modi0903/smart-classroom-stm32/docs/reports/final-review-slides.pdf

# Smart Classroom

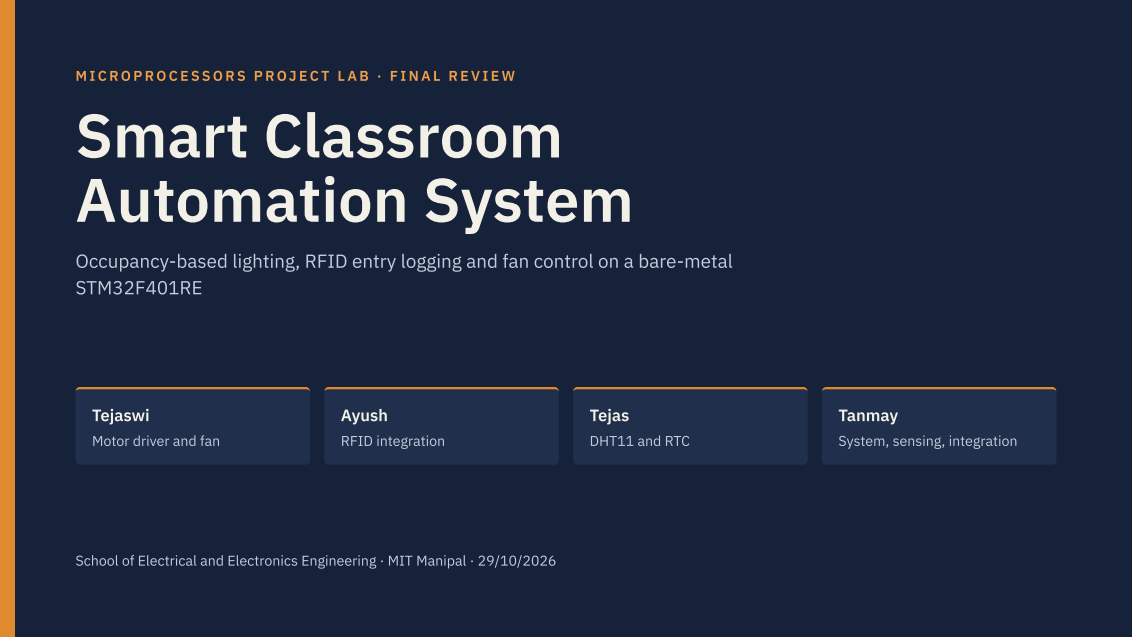
[picture p11: page 1]
Tejaswi; Ayush; RFID integration; Tejas; DHT11 and RTC; Tanmay

Automation System

Occupancy-based lighting, RFID entry logging and fan control on a bare-metal
STM32F401RE

Motor driver and fan

System, sensing, integration

School of Electrical and Electronics Engineering · MIT Manipal · 29/10/2026

AGENDA

# Presentation flow

# System overview, occupancy sensing and lighting

Problem, architecture, firmware structure, ultrasonic zones, debounce, lighting

RC522 on SPI2, ISO 14443-A card read, roster and lockout, link to the system

IRLZ44N low-side stage, TIM1 PWM at 20 kHz, button fan levels, RFID gating

DHT11 single-wire protocol, RTC clock source, backup domain, serial time setting

Interrupts, one-button screens, roster, class sessions, OLED, testing, demo

## Smart Classroom Automation System

INTRODUCTION

# Problem and objectives

# Classroom lights and fans are often

left running after the room empties.

Manual switching depends on the last person to leave,

and a fixed timer cannot tell whether anyone is present.

The loads should follow actual occupancy, ambient

light and the number of people inside.

# Objectives

1. Detect occupancy in two zones using ultrasonic ranging
2. Switch and dim zone lights by occupancy and ambient light
3. Record entry and exit at the door with RFID cards
4. Run the fan only while someone is inside, at a set speed
5. Display temperature, humidity, date and time
6. Write all firmware at register level, using interrupts

# System block diagram

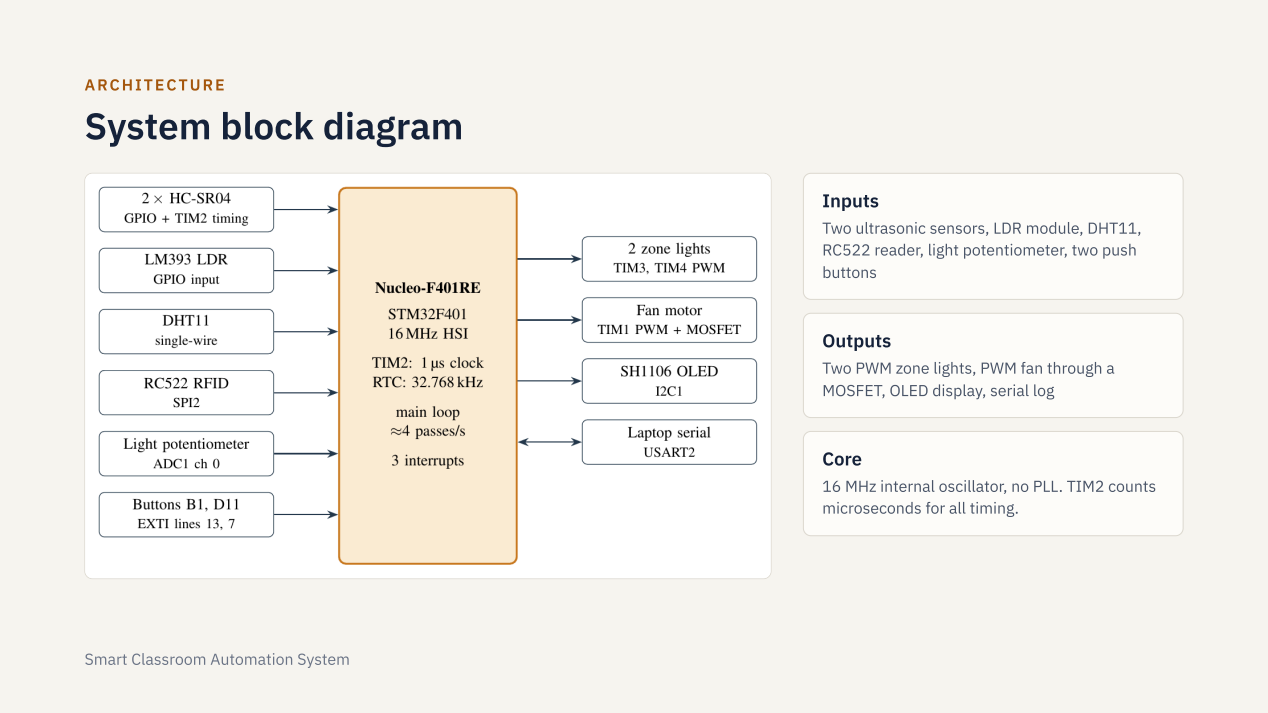
[picture p12: page 4]
ARCHITECTURE; Inputs; buttons; Outputs; Core

Two ultrasonic sensors, LDR module, DHT11,

RC522 reader, light potentiometer, two push

Two PWM zone lights, PWM fan through a

MOSFET, OLED display, serial log

16 MHz internal oscillator, no PLL. TIM2 counts

microseconds for all timing.

# How the platform was chosen

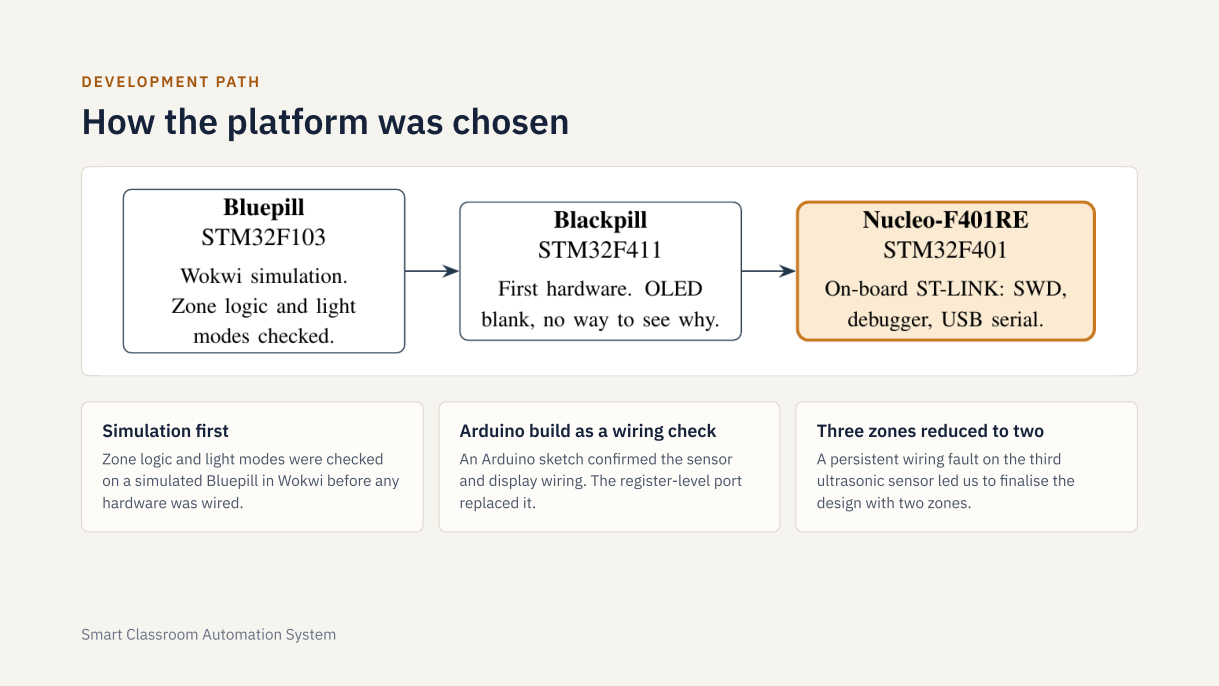
[picture p13: page 5]
DEVELOPMENT PATH; Simulation first; replaced it.

Arduino build as a wiring check

Three zones reduced to two

Zone logic and light modes were checked

An Arduino sketch confirmed the sensor

A persistent wiring fault on the third

on a simulated Bluepill in Wokwi before any

and display wiring. The register-level port

ultrasonic sensor led us to finalise the

hardware was wired.

design with two zones.

# Bare-metal structure and peripheral map

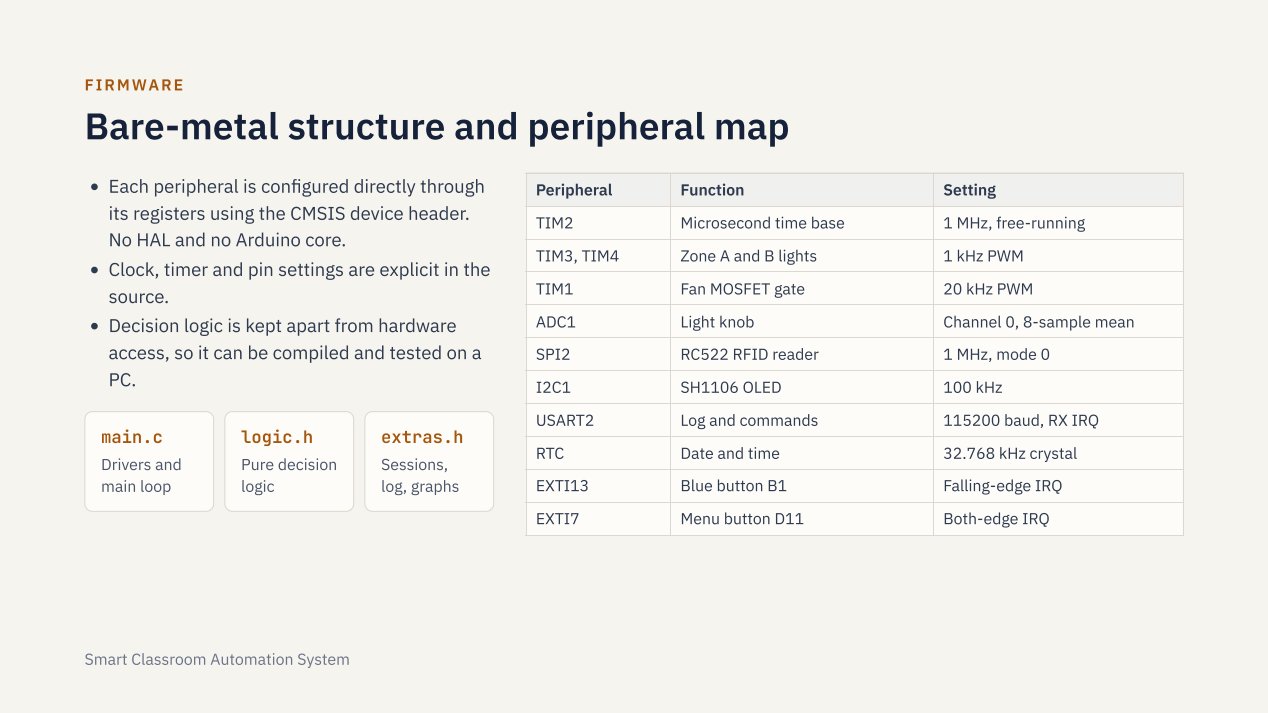
[picture p14: page 6]
FIRMWARE; source.; main.c; Drivers and; main loop; logic.h; Pure decision; logic; extras.h; Sessions,; log, graphs

Each peripheral is configured directly through

Peripheral | Function | Setting

its registers using the CMSIS device header.

TIM2 | Microsecond time base | 1 MHz, free-running

No HAL and no Arduino core.

TIM3, TIM4 | Zone A and B lights | 1 kHz PWM

Clock, timer and pin settings are explicit in the

TIM1 | Fan MOSFET gate | 20 kHz PWM

Decision logic is kept apart from hardware

ADC1 | Light knob | Channel 0, 8-sample mean

access, so it can be compiled and tested on a

SPI2 | RC522 RFID reader | 1 MHz, mode 0

I2C1 | SH1106 OLED | 100 kHz

USART2 | Log and commands | 115200 baud, RX IRQ

RTC | Date and time | 32.768 kHz crystal

EXTI13 | Blue button B1 | Falling-edge IRQ

EXTI7 | Menu button D11 | Both-edge IRQ

# One pass of the main loop, about 0.25 s

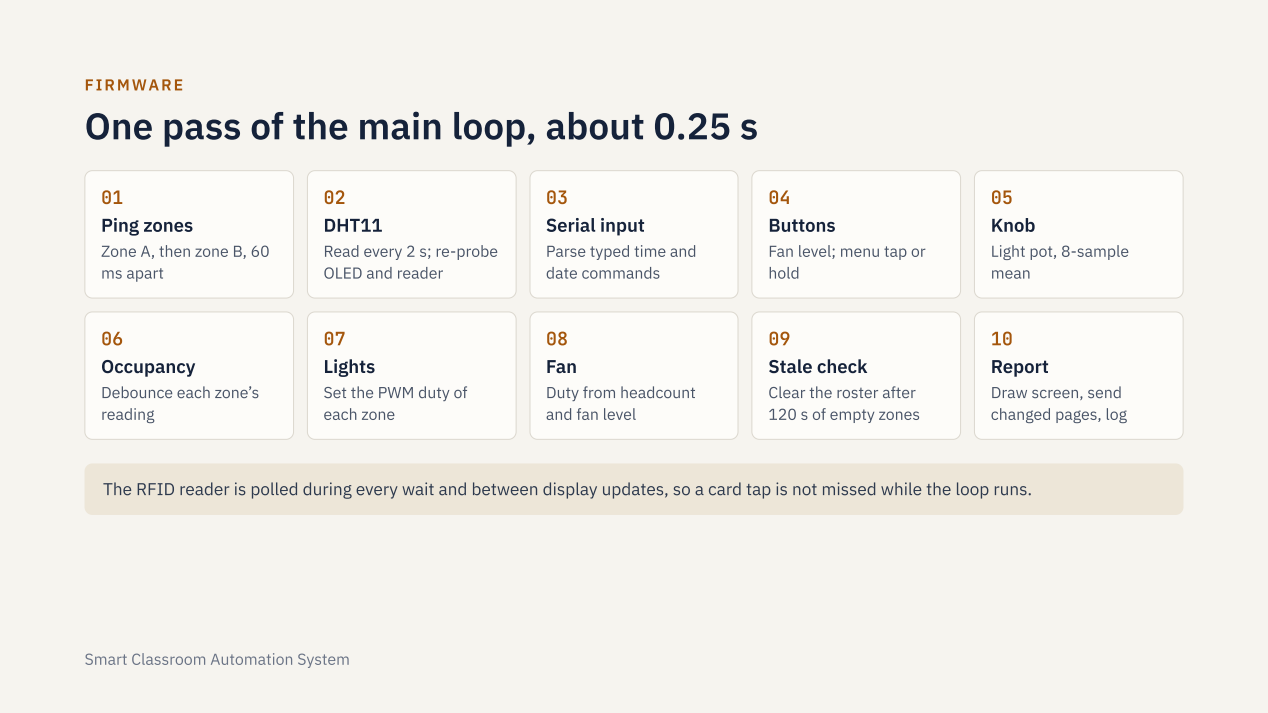
[picture p15: page 7]
FIRMWARE; Ping zones; ms apart; DHT11; Serial input; date commands; Buttons; Knob; mean; Occupancy; reading; Lights; each zone; Fan; Stale check; Report

Zone A, then zone B, 60

Read every 2 s; re-probe

Parse typed time and

Fan level; menu tap or
hold

Light pot, 8-sample

OLED and reader

Debounce each zone’s

Set the PWM duty of

Duty from headcount

Clear the roster after

Draw screen, send

and fan level

120 s of empty zones

changed pages, log

The RFID reader is polled during every wait and between display updates, so a card tap is not missed while the loop runs.

OCCUPANCY SENSING

# Ultrasonic distance measurement

# Measurement sequence

1. Drive TRIG high for 10 µs.
2. Wait up to 5 ms for ECHO to rise, else report NO ECHO.
3. Time the ECHO pulse on TIM2; beyond 25 ms, report FAR.
4. Distance in cm = echo time in µs ÷ 58.
5. A distance under 100 cm counts as a person present.

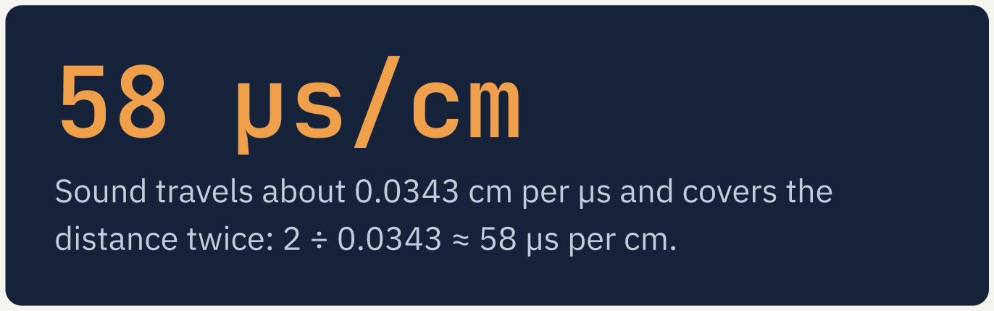
[picture p16: figure]

Sound travels about 0.0343 cm per µs and covers the

distance twice: 2 ÷ 0.0343 ≈ 58 µs per cm.

Zone | TRIG | ECHO
A | PA10 (D2) | PB3 (D3)
B | PB5 (D4) | PB4 (D5)

Sensors run from 5 V. The two zones are pinged 60 ms apart so one

sensor’s echo is not read by the other.

# Asymmetric debounce of each zone

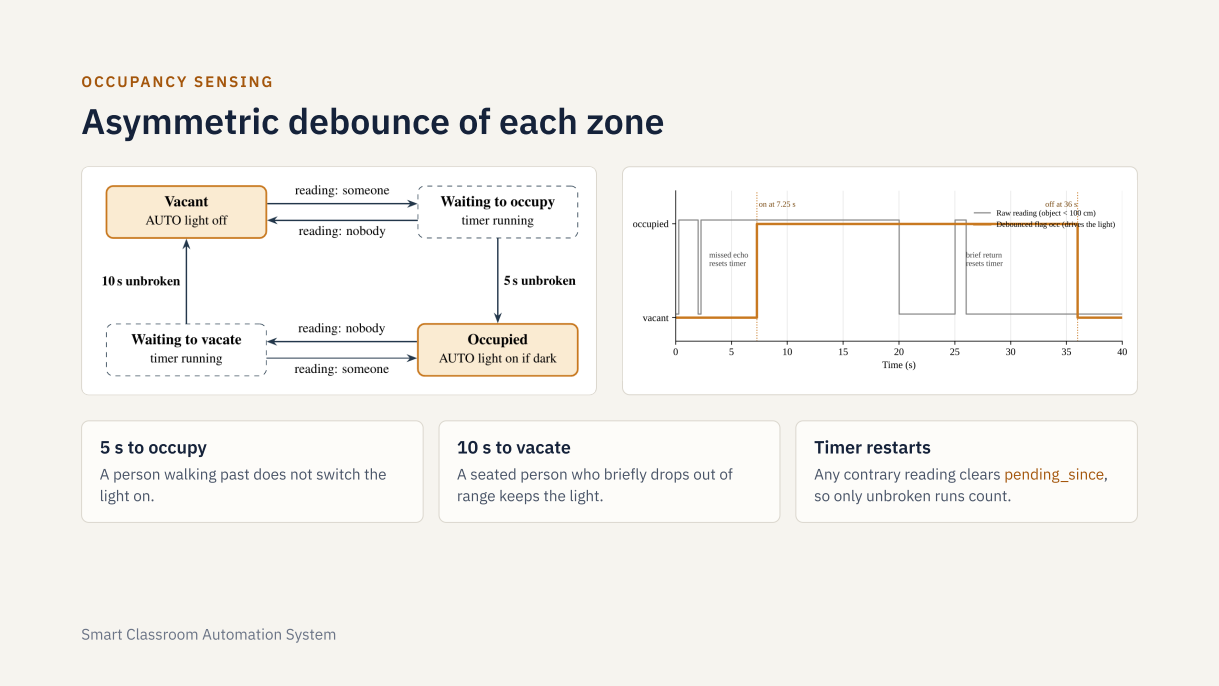
[picture p17: page 9]
OCCUPANCY SENSING; 5 s to occupy; 10 s to vacate

Timer restarts
Any contrary reading clears pending_since,

A person walking past does not switch the
light on.

A seated person who briefly drops out of

range keeps the light.

so only unbroken runs count.

LIGHTING

# Zone lights: modes, PWM and ambient light

Setting | Light output
OFF | Always off
AUTO (default) | Knob brightness when occupied and dark
DIM | Fixed low level, 10 % duty
MAX | Knob brightness at all times

Each zone’s mode is set at compile time; the final build runs both zones in AUTO.

There is no run-time override: the blue button now sets the fan level.

PWM outputs

TIM3 CH2 on PC7 (D9), TIM4 CH1 on PB6 (D10). 16 MHz ÷ 16 ÷

1000 = 1 kHz, duty 0 to 999.

Ambient light

LM393 module output on PB0, internal pull-up. HIGH means

dark.

Brightness knob

PA0 (A0), ADC1 channel 0. On the HOME screen the 12-bit

reading maps to duty 50 to 999, with a small dead band against

flicker.

02

# RFID entry at the door

## Reading ISO 14443-A cards with the RC522 over SPI, keeping a roster of who is

inside, and passing the headcount to the rest of the system.

# RC522 reader on SPI2

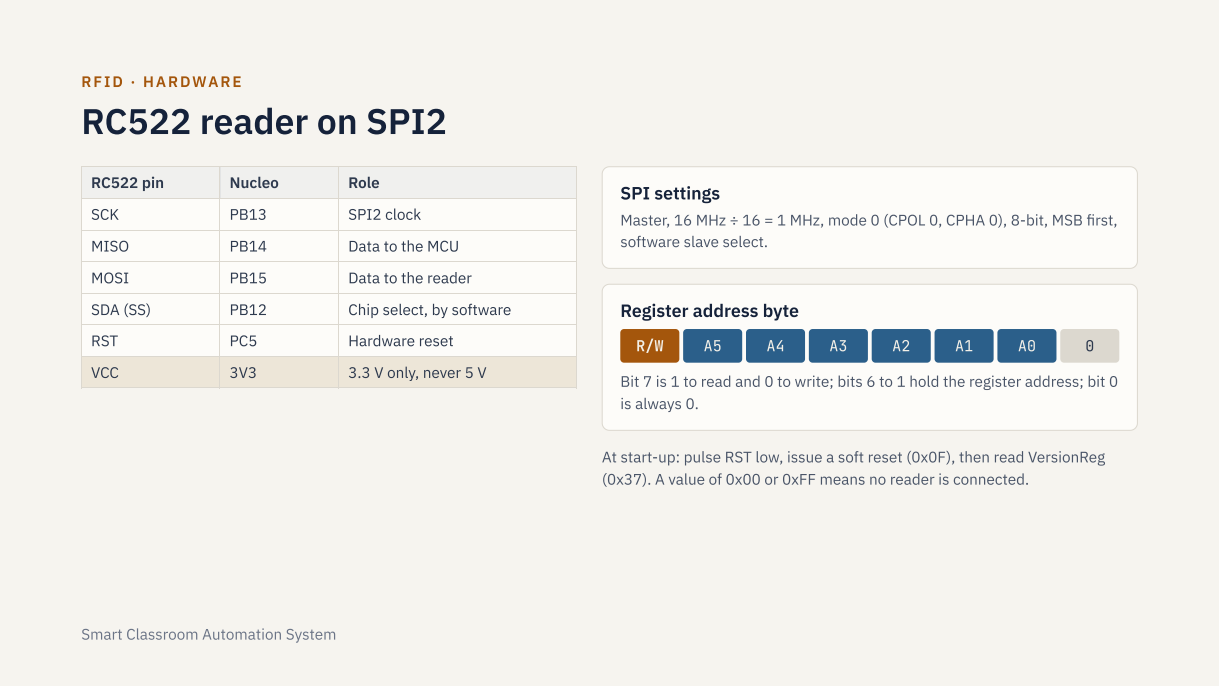
[picture p18: page 12]
RFID · HARDWARE; SPI settings; is always 0.

RC522 pin | Nucleo | Role

SCK | PB13 | SPI2 clock

Master, 16 MHz ÷ 16 = 1 MHz, mode 0 (CPOL 0, CPHA 0), 8-bit, MSB first,

MISO | PB14 | Data to the MCU

software slave select.

MOSI | PB15 | Data to the reader

SDA (SS) | PB12 | Chip select, by software

Register address byte

RST | PC5 | Hardware reset

VCC | 3V3 | 3.3 V only, never 5 V

Bit 7 is 1 to read and 0 to write; bits 6 to 1 hold the register address; bit 0

At start-up: pulse RST low, issue a soft reset (0x0F), then read VersionReg

(0x37). A value of 0x00 or 0xFF means no reader is connected.

# Reading a card, ISO 14443-A

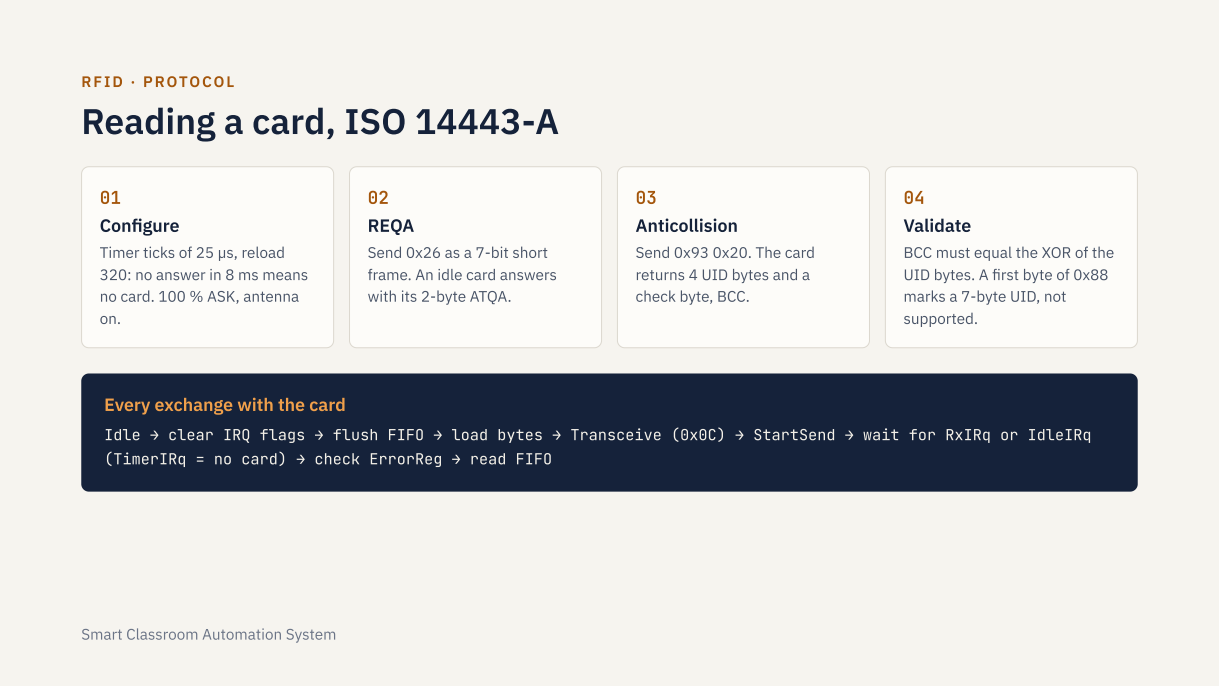
[picture p19: page 13]
RFID · PROTOCOL; Configure; REQA; Anticollision; Validate; supported.

Timer ticks of 25 µs, reload

Send 0x26 as a 7-bit short

Send 0x93 0x20. The card

BCC must equal the XOR of the

320: no answer in 8 ms means

frame. An idle card answers

returns 4 UID bytes and a

UID bytes. A first byte of 0x88

no card. 100 % ASK, antenna

with its 2-byte ATQA.

check byte, BCC.

marks a 7-byte UID, not

Every exchange with the card

Idle → clear IRQ flags → flush FIFO → load bytes → Transceive (0x0C) → StartSend → wait for RxIRq or IdleIRq

(TimerIRq = no card) → check ErrorReg → read FIFO

# Turning taps into a headcount

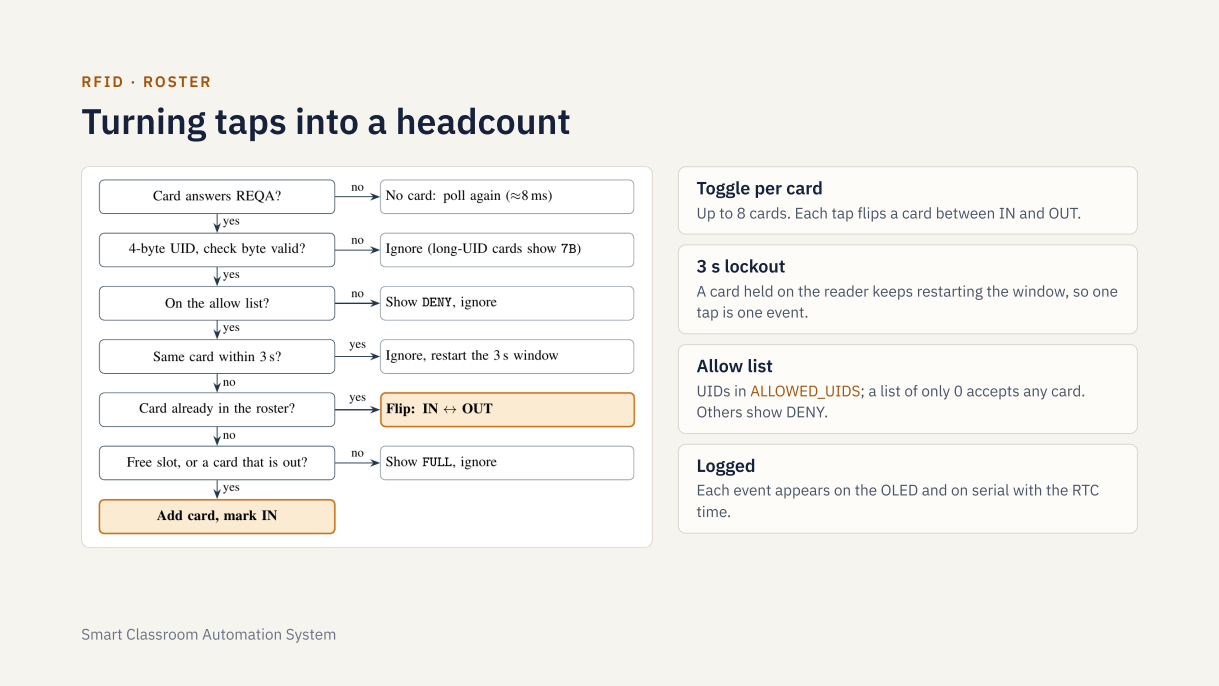
[picture p20: page 14]
RFID · ROSTER; 3 s lockout; Allow list; Logged; time.

Toggle per card

Up to 8 cards. Each tap flips a card between IN and OUT.

A card held on the reader keeps restarting the window, so one

tap is one event.

UIDs in ALLOWED_UIDS; a list of only 0 accepts any card.

Others show DENY.

Each event appears on the OLED and on serial with the RTC

RFID · INTEGRATION

# How the headcount drives the room

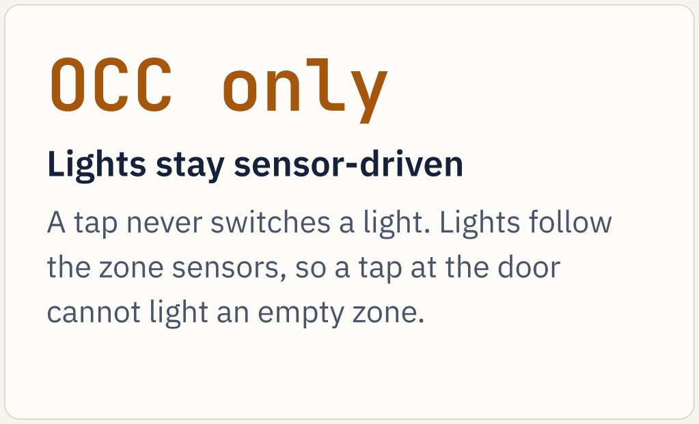
[picture p21: figure]
OCC only; Lights stay sensor-driven; the zone sensors, so a tap at the door; cannot light an empty zone.

A tap never switches a light. Lights follow

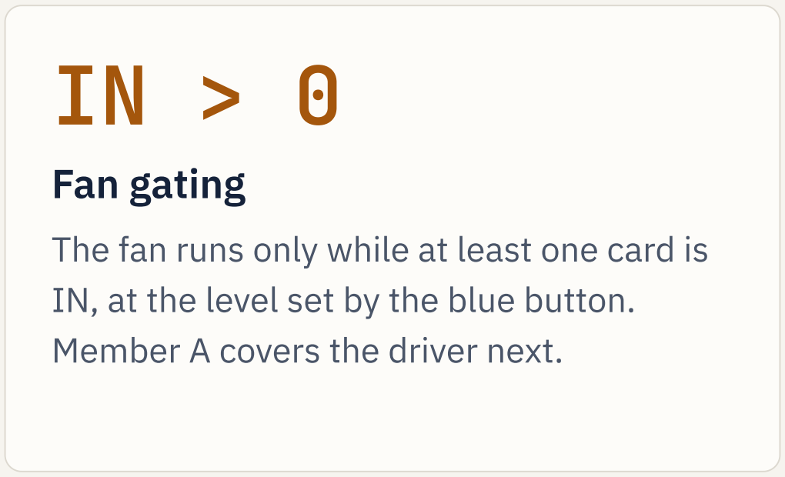
[picture p22: figure]
Fan gating; Member A covers the driver next.

The fan runs only while at least one card is

IN, at the level set by the blue button.

120 s

Stale reset

If cards are IN but both zones stay vacant

for 120 s, the roster is cleared. The timer

starts 30 s after the last tap-in. This covers

people who leave without tapping out.

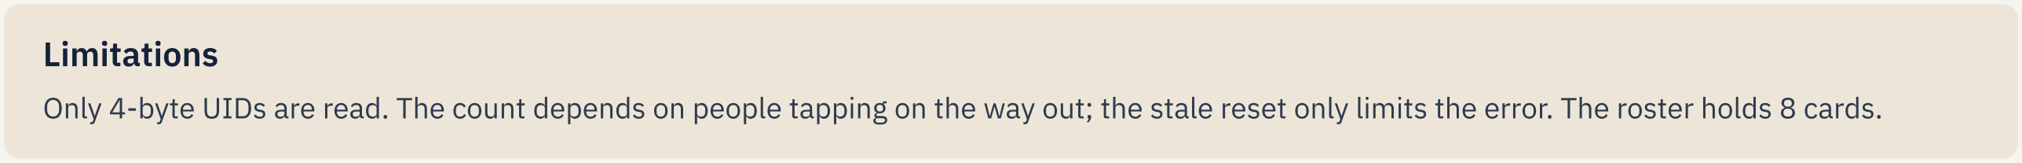
[picture p23: figure]
Limitations

Only 4-byte UIDs are read. The count depends on people tapping on the way out; the stale reset only limits the error. The roster holds 8 cards.

03

# Motor driver and fan control

## Switching a 9 V motor from a 3.3 V pin with a logic-level MOSFET, generating the PWM

on TIM1, and deciding when and how fast the fan runs.

MOTOR DRIVER · CIRCUIT

# Low-side MOSFET driver stage

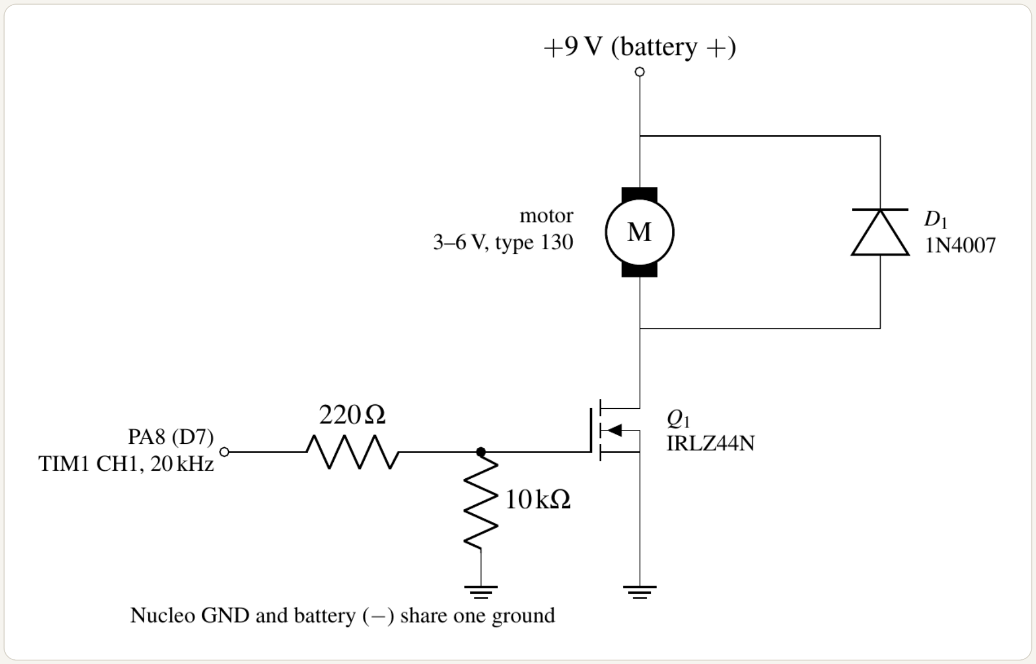
[picture p24: figure]

Part | Value | Purpose
Q1 | IRLZ44N | Switch
D1 | 1N4007 | Flyback path
Gate R | 220 Ω | Limit current
Pull-down | 10 kΩ | Gate off at reset
Supply | 9 V battery | Motor power
Motor | Type 130, 3–6 V | Fan

Battery negative is joined to the Nucleo ground. Without a

shared ground the gate voltage has no reference.

MOTOR DRIVER · DESIGN

# Why each component is there

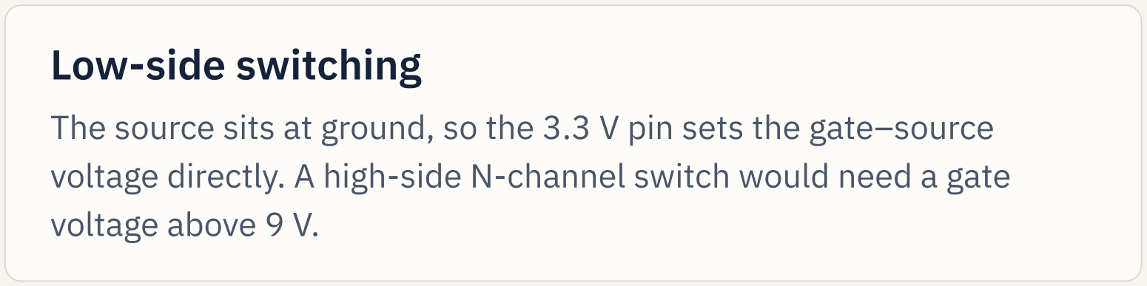
[picture p25: figure]
Low-side switching; voltage above 9 V.

The source sits at ground, so the 3.3 V pin sets the gate–source

voltage directly. A high-side N-channel switch would need a gate

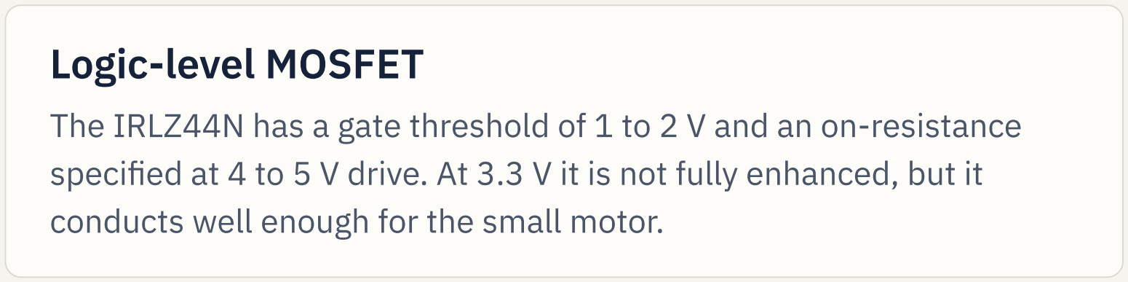
[picture p26: figure]
Logic-level MOSFET

The IRLZ44N has a gate threshold of 1 to 2 V and an on-resistance

specified at 4 to 5 V drive. At 3.3 V it is not fully enhanced, but it

conducts well enough for the small motor.

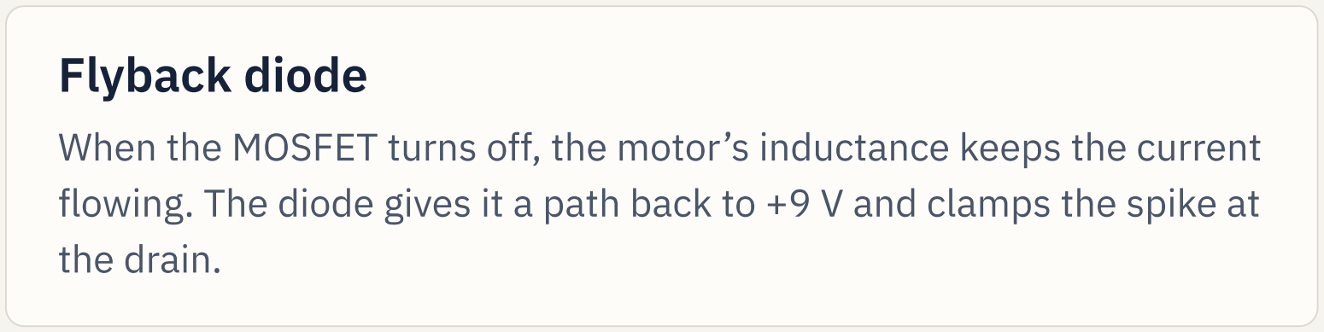
[picture p27: figure]
Flyback diode; the drain.

When the MOSFET turns off, the motor’s inductance keeps the current

flowing. The diode gives it a path back to +9 V and clamps the spike at

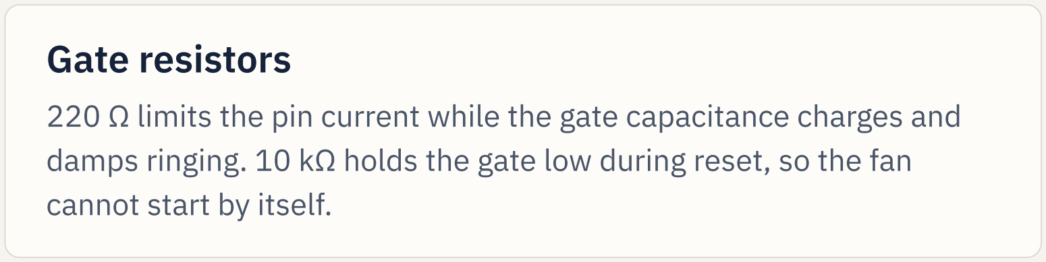
[picture p28: figure]
Gate resistors; cannot start by itself.

220 Ω limits the pin current while the gate capacitance charges and

damps ringing. 10 kΩ holds the gate low during reset, so the fan

Known improvement: the 1N4007 is a slow-recovery rectifier. A Schottky diode would suit 20 kHz switching better.

# Generating the fan PWM on TIM1

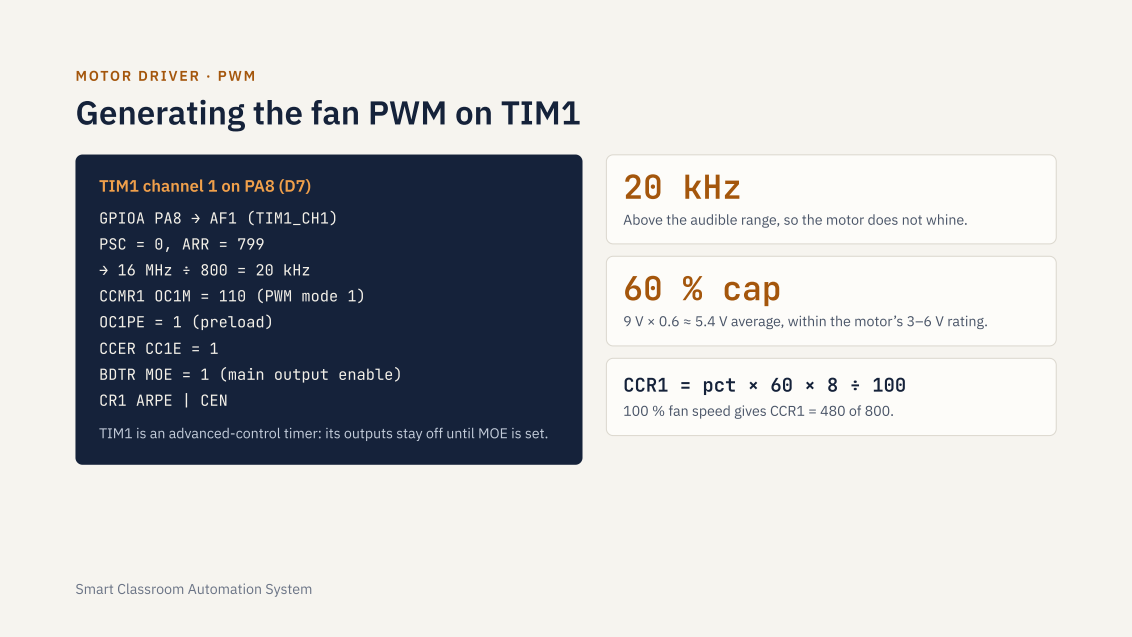
[picture p29: page 19]
TIM1 channel 1 on PA8 (D7); GPIOA PA8 → AF1 (TIM1_CH1); PSC = 0, ARR = 799; → 16 MHz ÷ 800 = 20 kHz; CCMR1 OC1M = 110 (PWM mode 1); OC1PE = 1 (preload); CCER CC1E = 1; CR1 ARPE | CEN; 20 kHz; 60 % cap; CCR1 = pct × 60 × 8 ÷ 100

MOTOR DRIVER · PWM

Above the audible range, so the motor does not whine.

9 V × 0.6 ≈ 5.4 V average, within the motor’s 3–6 V rating.

BDTR MOE = 1 (main output enable)

100 % fan speed gives CCR1 = 480 of 800.

TIM1 is an advanced-control timer: its outputs stay off until MOE is set.

# When the fan runs, and how fast

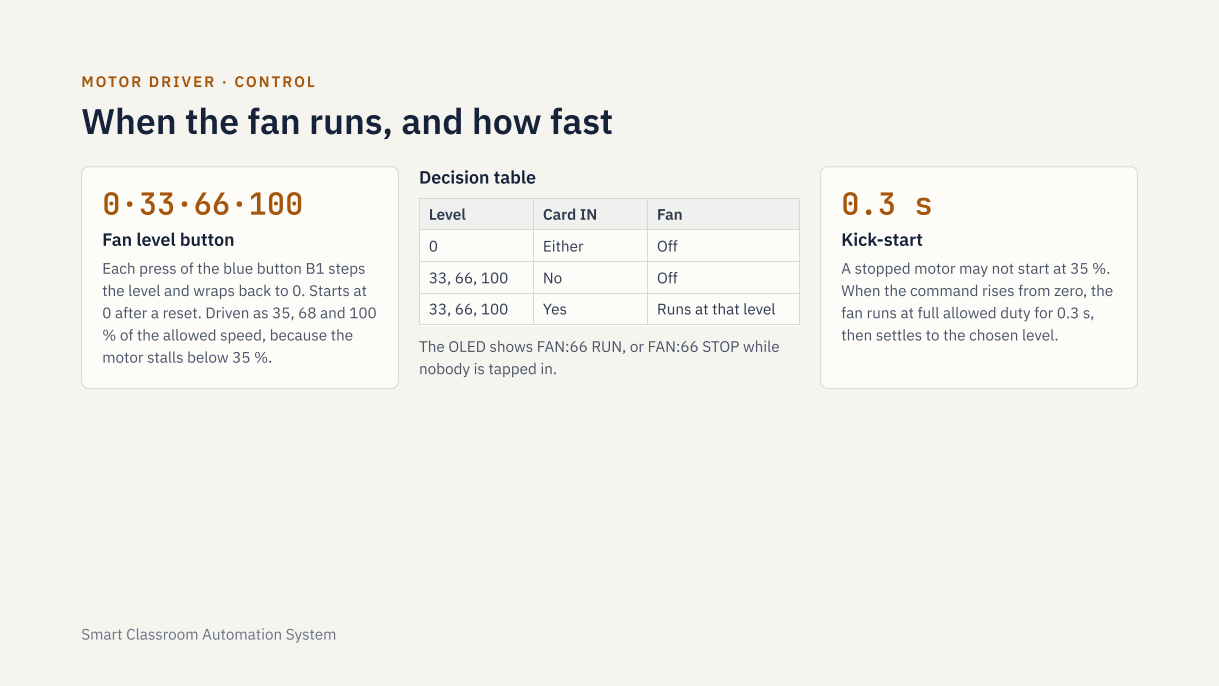
[picture p30: page 20]
Decision table; Kick-start

MOTOR DRIVER · CONTROL

Level | Card IN | Fan

Fan level button

0 | Either | Off

Each press of the blue button B1 steps

A stopped motor may not start at 35 %.

33, 66, 100 | No | Off

the level and wraps back to 0. Starts at

When the command rises from zero, the

0 after a reset. Driven as 35, 68 and 100

33, 66, 100 | Yes | Runs at that level

fan runs at full allowed duty for 0.3 s,

% of the allowed speed, because the

then settles to the chosen level.

The OLED shows FAN:66 RUN, or FAN:66 STOP while

motor stalls below 35 %.

nobody is tapped in.

04

# Environment sensing and timekeeping

## Reading temperature and humidity from the DHT11 over a single wire, and keeping

date and time with the on-chip real-time clock.

DHT11 · PROTOCOL

# Single-wire temperature and humidity read

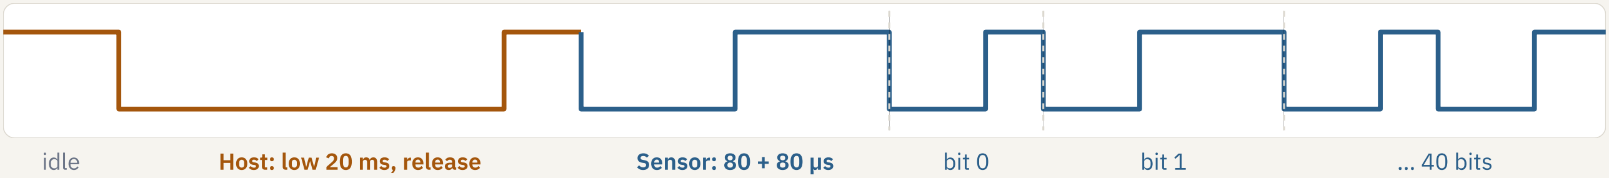
[picture p31: figure]
idle; Host: low 20 ms, release; Sensor: 80 + 80 µs; bit 0; bit 1; … 40 bits

Start

The MCU pulls the line low for

20 ms, then releases it.

Response

The sensor pulls low about 80

µs, then high about 80 µs.

40 data bits

50 µs low, then high: 26–28 µs

is 0, about 70 µs is 1.

Threshold 45 µs.

Checksum

Byte 4 = low 8 bits of bytes 0 to

3 summed. Byte 0 is humidity,

byte 2 temperature.

PA9 (D8), open-drain with pull-up. Read every 2 s; each read blocks for about 25 ms. Every edge has a 100 µs timeout; a failed read shows DHT11

# On-chip RTC: clock source and set-up

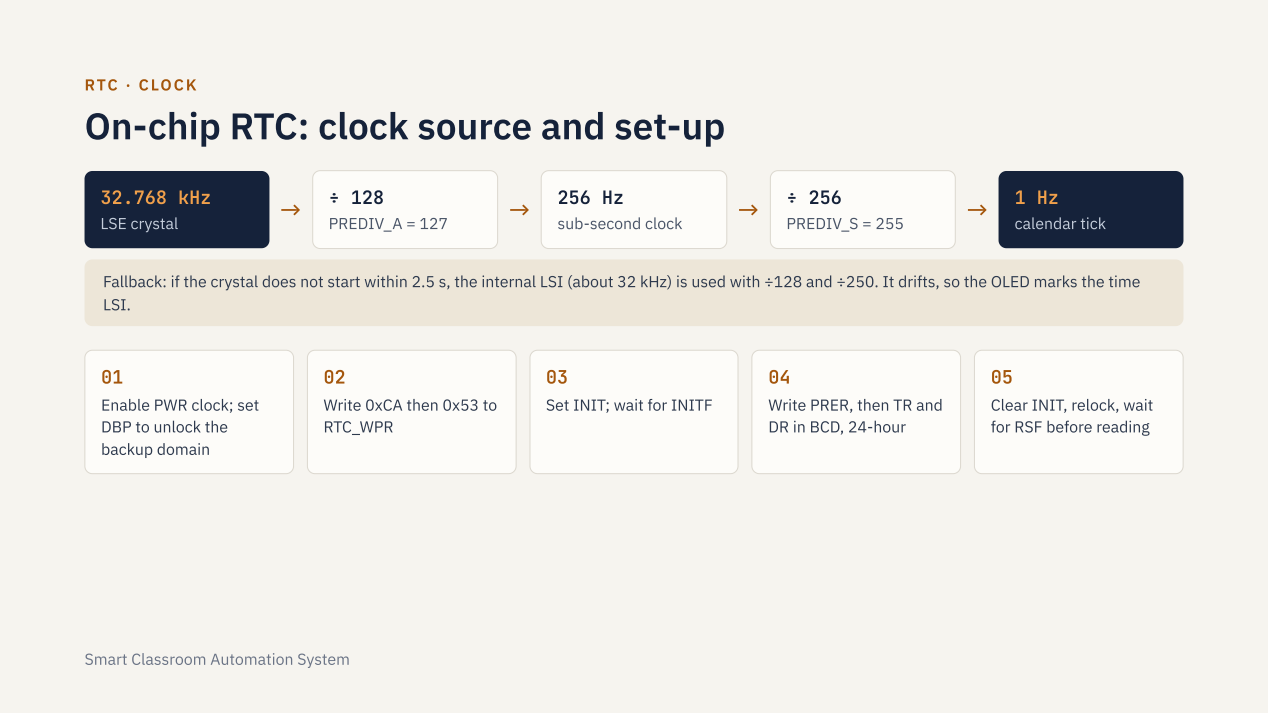
[picture p32: page 23]
RTC · CLOCK; 32.768 kHz; LSE crystal; PREDIV_A = 127; PREDIV_S = 255; calendar tick; LSI.; backup domain; RTC_WPR

sub-second clock

Fallback: if the crystal does not start within 2.5 s, the internal LSI (about 32 kHz) is used with ÷128 and ÷250. It drifts, so the OLED marks the time

Enable PWR clock; set

Write 0xCA then 0x53 to

Set INIT; wait for INITF

Write PRER, then TR and

Clear INIT, relock, wait

DBP to unlock the

DR in BCD, 24-hour

for RSF before reading

RTC · PERSISTENCE

# Keeping and setting the time

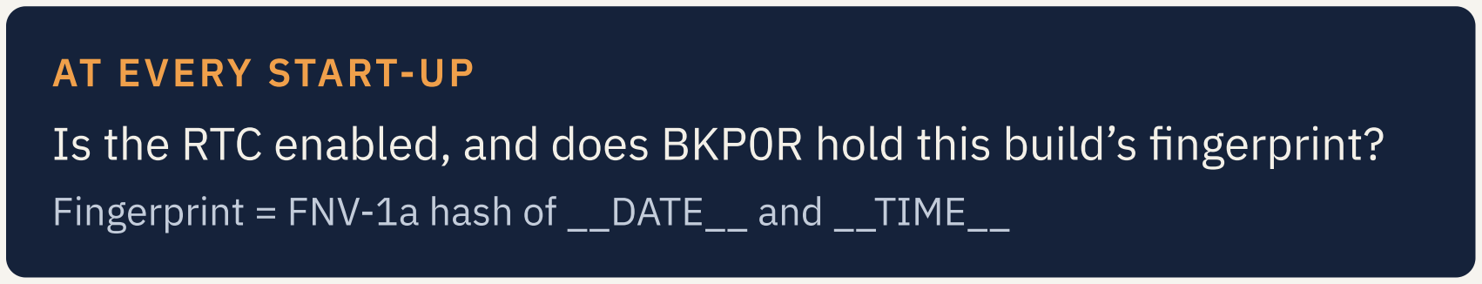
[picture p33: figure]
AT EVERY START-UP

Is the RTC enabled, and does BKP0R hold this build’s fingerprint?

Fingerprint = FNV-1a hash of __DATE__ and __TIME__

## Yes: plain reset

Leave the running clock alone. The

time survives the reset.

## No: new build or power loss

Reset the backup domain, start the

LSE, set the time from the build

timestamp, store the fingerprint.

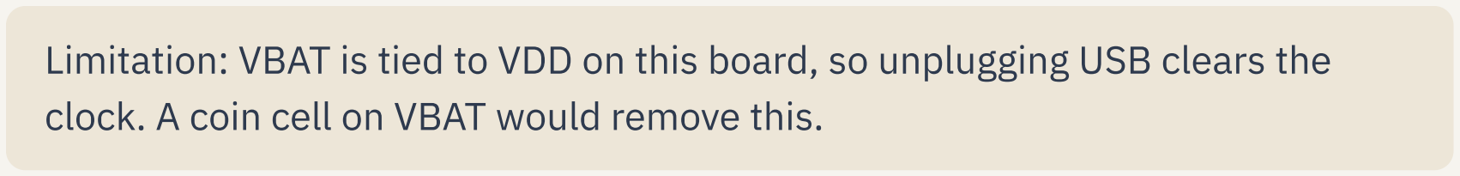
[picture p34: figure]

Limitation: VBAT is tied to VDD on this board, so unplugging USB clears the

clock. A coin cell on VBAT would remove this.

Serial commands

T 08:30

T 08:30:15

D 27/10/26

?

Set time, set time with seconds, set date, show both. Invalid

input is rejected with a usage message.

Characters arrive through the USART2 receive interrupt; the

main loop assembles and parses each line.

The final build adds R (roster), L (event log as CSV) and S

(class status and attendance).

05

# Interrupts, interface and results

## How button and serial events are handled, the one-button interface with its five

## screens, the roster and class sessions, how the system was verified, and what we

learned.

INTERRUPTS

# Three interrupt handlers

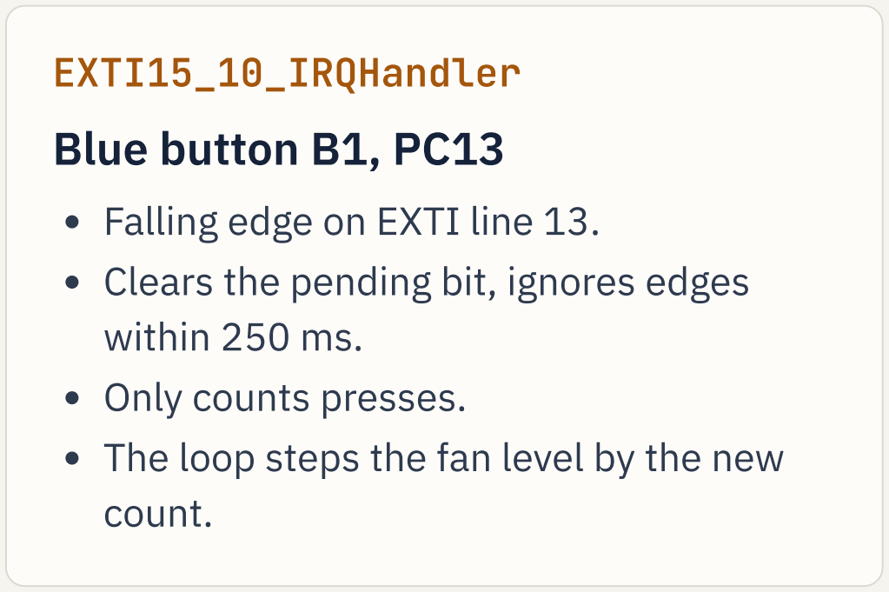
[picture p35: figure]
EXTI15_10_IRQHandler; Blue button B1, PC13; Falling edge on EXTI line 13.; Clears the pending bit, ignores edges; within 250 ms.; Only counts presses.; The loop steps the fan level by the new; count.
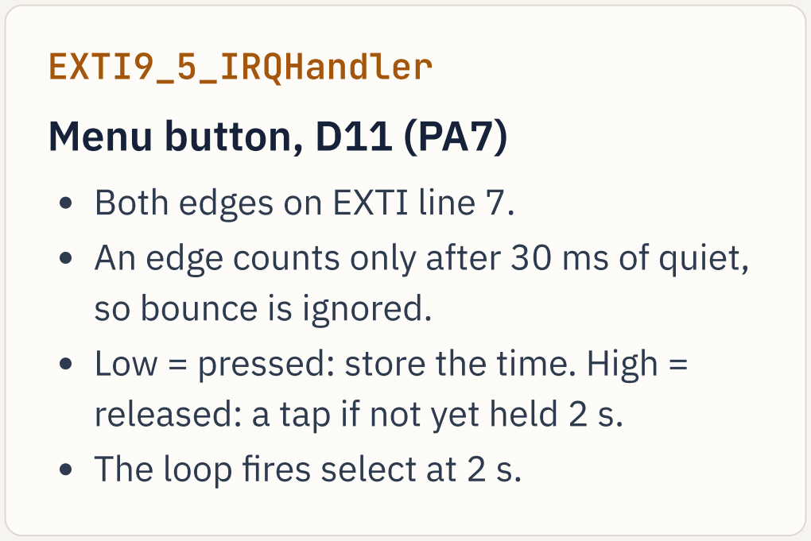
[picture p36: figure]
EXTI9_5_IRQHandler; Menu button, D11 (PA7); Both edges on EXTI line 7.; so bounce is ignored.; Low = pressed: store the time. High =; released: a tap if not yet held 2 s.; The loop fires select at 2 s.

An edge counts only after 30 ms of quiet,

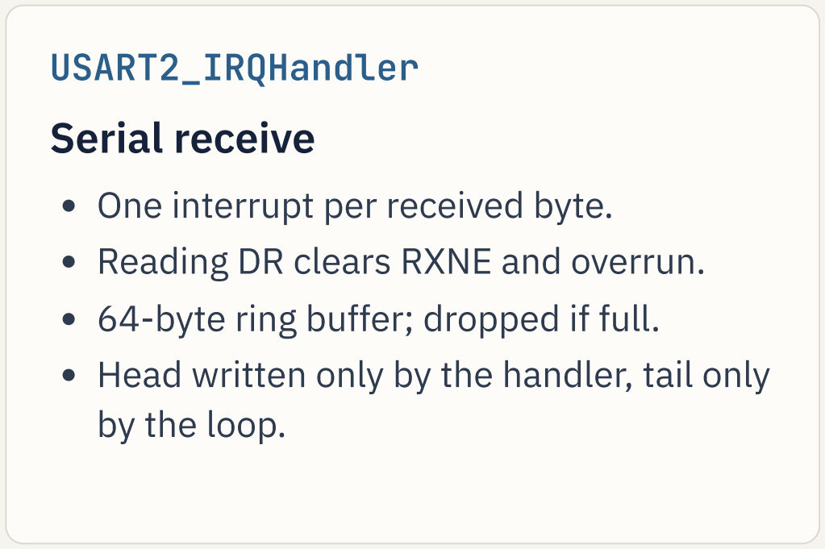
[picture p37: figure]
USART2_IRQHandler; Serial receive; One interrupt per received byte.; Reading DR clears RXNE and overrun.; 64-byte ring buffer; dropped if full.; by the loop.

Head written only by the handler, tail only

Handlers only record events. Every decision is taken in the main loop.

USER INTERFACE

# One button, five screens

Control | What it does
D11, tap | Next screen on release: HOME, ROSTER, LOG, CLASS, GRAPH
D11, hold 2 s | The screen’s action, fired while still held
Blue button B1 | Fan level 0 → 33 → 66 → 100 → 0, on any screen
Light knob | HOME: brightness. Other screens: pick, scroll or set

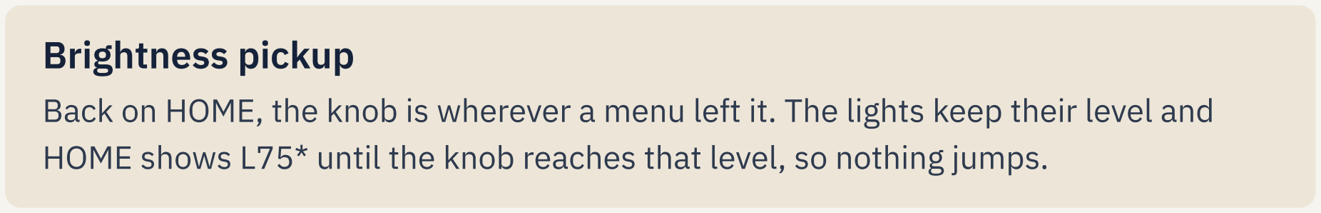
[picture p38: figure]
Brightness pickup

Back on HOME, the knob is wherever a menu left it. The lights keep their level and

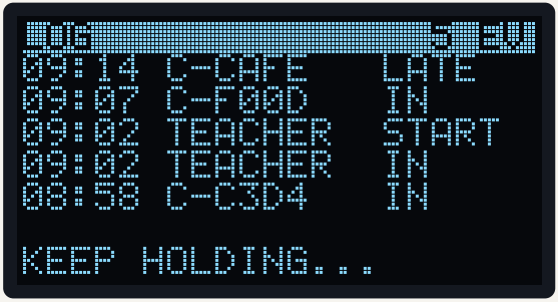
[picture p39: figure]

HOME shows L75* until the knob reaches that level, so nothing jumps. | After 0.4 s of holding, the bottom line shows KEEP
| HOLDING... so a hold is never mistaken for a tap.

USER INTERFACE

# The five screens

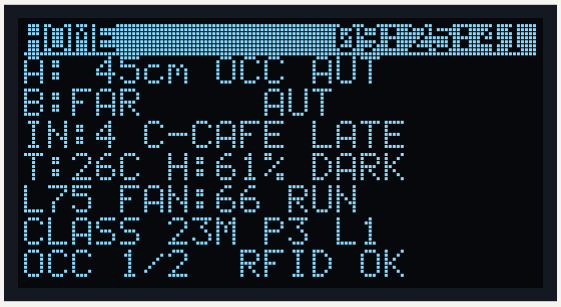
[picture p40: figure]

HOME

Live status. Knob: brightness.

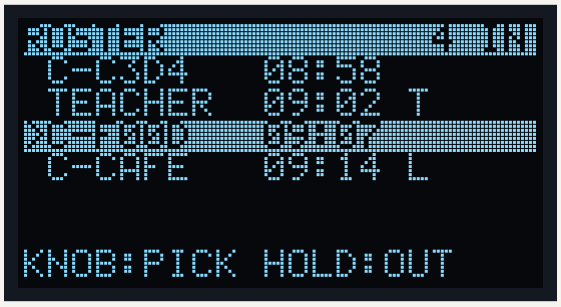
[picture p41: figure]

ROSTER

Knob: pick a person. Hold: mark OUT.

LOG

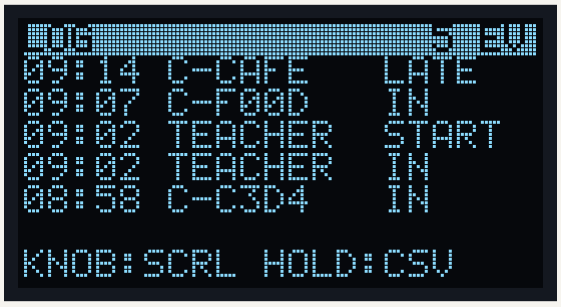
[picture p42: figure]

Knob scrolls. Hold: CSV to serial.

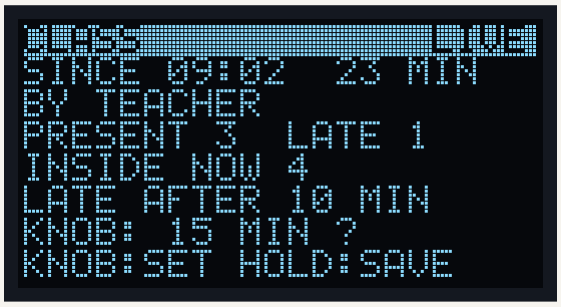
[picture p43: figure]

CLASS

Knob: late limit. Hold: save.


GRAPH

Knob: TEMP/HUM/PEOPLE. Hold: freeze.

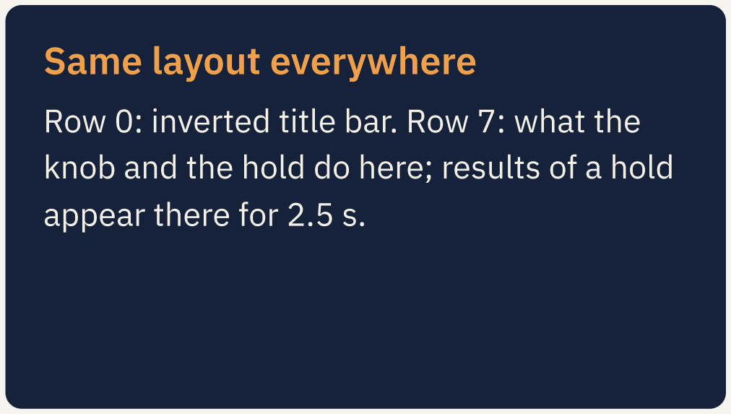
[picture p44: figure]
Same layout everywhere; appear there for 2.5 s.

Row 0: inverted title bar. Row 7: what the

knob and the hold do here; results of a hold

# Teacher sessions and LATE marking

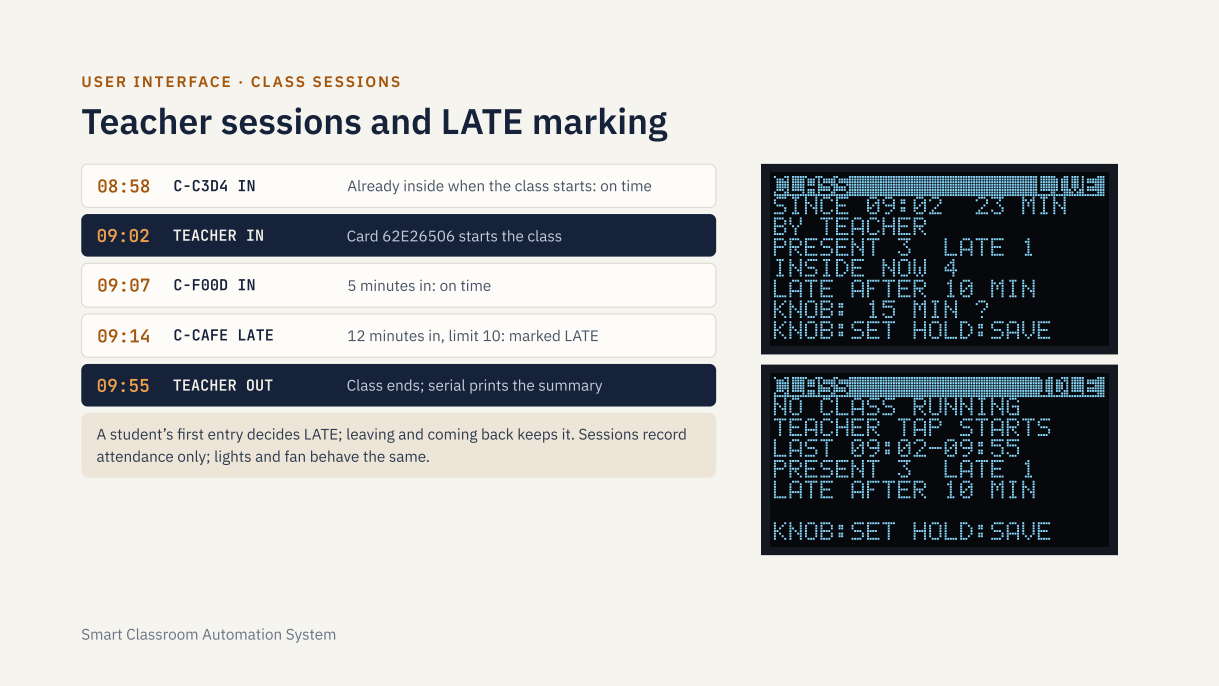
[picture p45: page 29]
Already inside when the class starts: on time; TEACHER IN; Card 62E26506 starts the class; 5 minutes in: on time; C-CAFE LATE; 12 minutes in, limit 10: marked LATE; TEACHER OUT; Class ends; serial prints the summary

USER INTERFACE · CLASS SESSIONS

A student’s first entry decides LATE; leaving and coming back keeps it. Sessions record

attendance only; lights and fan behave the same.

USER INTERFACE · DATA

# How the roster, log and class are stored

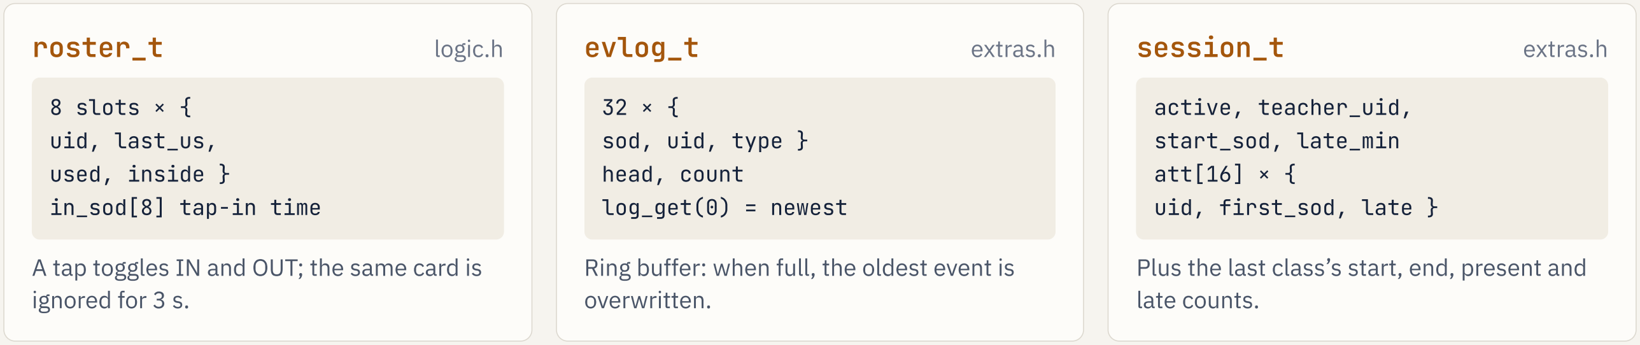
[picture p46: figure]
roster_t; logic.h; 8 slots × {; uid, last_us,; used, inside }; in_sod[8] tap-in time; ignored for 3 s.; evlog_t; extras.h; sod, uid, type }; head, count; log_get(0) = newest; overwritten.; session_t; active, teacher_uid,; start_sod, late_min; att[16] × {; uid, first_sod, late }; late counts.

A tap toggles IN and OUT; the same card is

Ring buffer: when full, the oldest event is

Plus the last class’s start, end, present and

CARDS[] in main.c maps a UID to a name and a role. Unnamed cards Times are seconds since midnight from the RTC. The late limit is kept in

USER INTERFACE · DISPLAY

# Drawing the screens

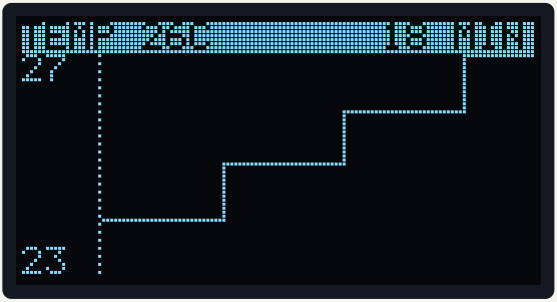
[picture p47: figure]
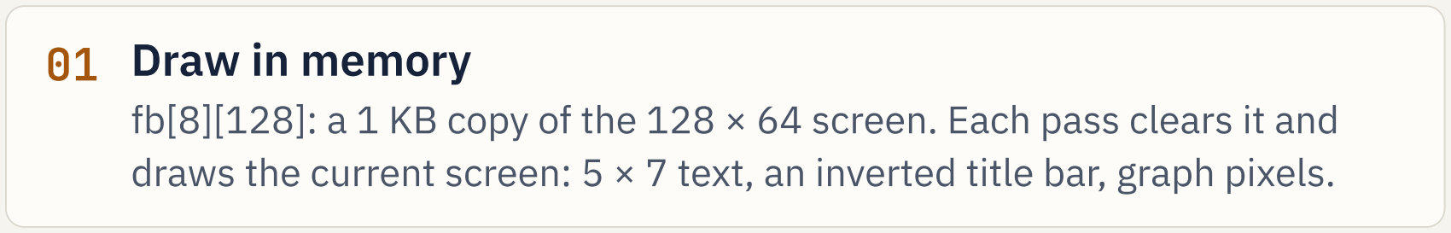
[picture p48: figure]
01 Draw in memory

fb[8][128]: a 1 KB copy of the 128 × 64 screen. Each pass clears it and

draws the current screen: 5 × 7 text, an inverted title bar, graph pixels.

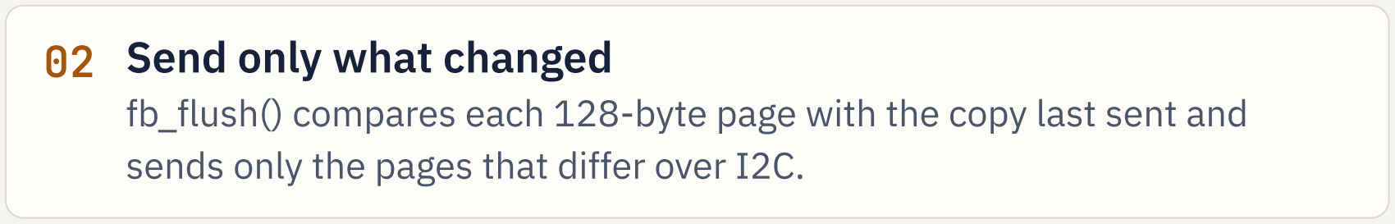
[picture p49: figure]
02 Send only what changed

fb_flush() compares each 128-byte page with the copy last sent and

sends only the pages that differ over I2C.

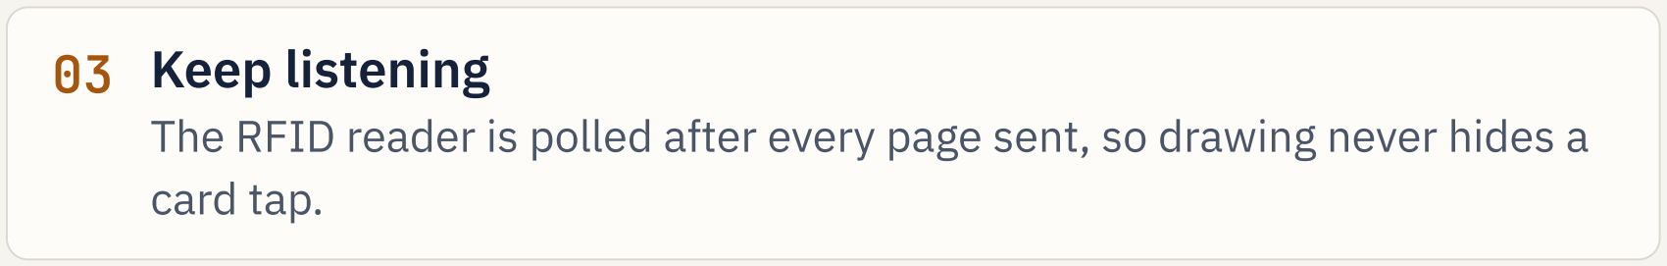
[picture p50: figure]
03 Keep listening; card tap.

The RFID reader is polled after every page sent, so drawing never hides a

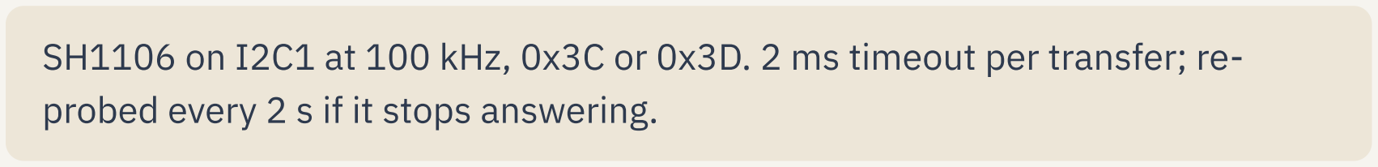
[picture p51: figure]
probed every 2 s if it stops answering.

SH1106 on I2C1 at 100 kHz, 0x3C or 0x3D. 2 ms timeout per transfer; re-

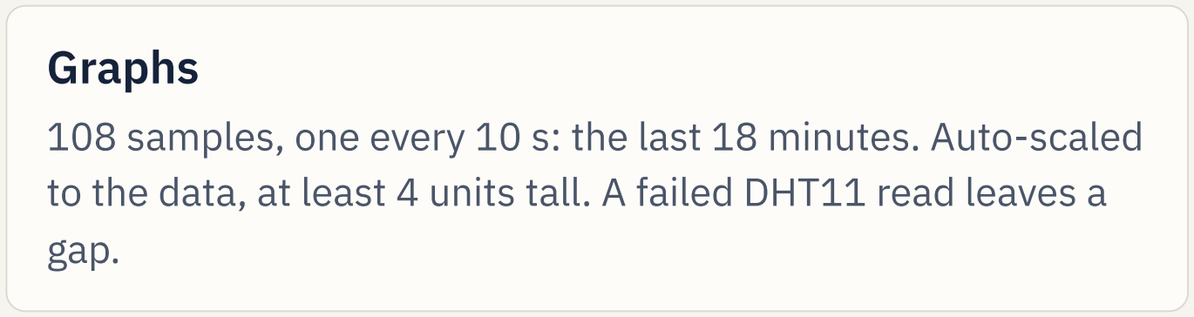
[picture p52: figure]
Graphs; gap.

108 samples, one every 10 s: the last 18 minutes. Auto-scaled

to the data, at least 4 units tall. A failed DHT11 read leaves a

VERIFICATION

# Testing on the PC and on the board

551

automated checks on logic.h and extras.h,

compiled with gcc and run on a PC

Roster and lockout, light duty, fan levels, kick-

start, duty cap, date and time parsing, card

names, class sessions and LATE marking, event

log, knob steps, brightness pickup and graph

scaling. The menu button’s tap and hold logic

was also run on the PC with simulated bounce.

Hardware checks

Action | Expected
Stand in zone A for 5 s, LDR covered | Zone A OCC, light on
Leave zone A for 10 s | Zone A clears, light off
Turn the light knob | Brightness follows the knob
Tap a card, then tap again | IN with count 1, then OUT, 0
Tap in, press B1 once | FAN:33 RUN, fan kicks then runs
Tap D11; hold D11 for 2 s | Next screen; screen action
Teacher card, student after the limit | CLASS START; student LATE
Type T 10:15 on serial | OLED shows 10:15:00
Disconnect the DHT11 | DHT11 ERROR, loop continues

# Memory and timing

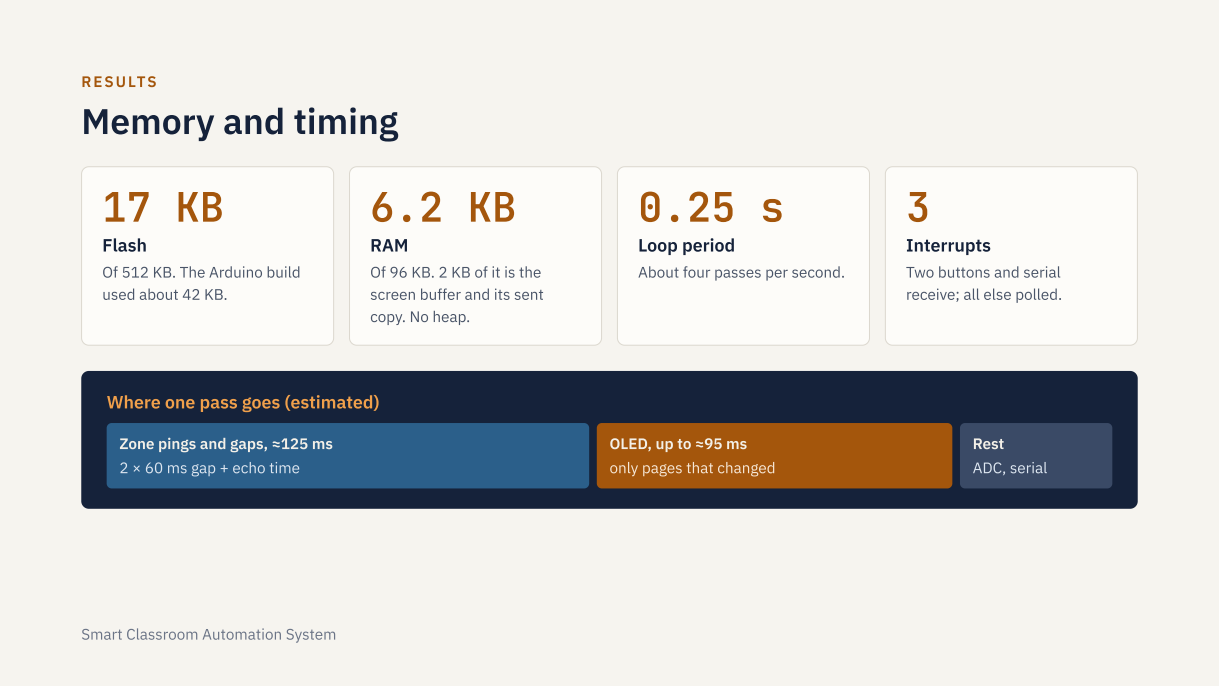
[picture p53: page 33]
RESULTS; Flash; RAM; Loop period; Interrupts; Rest; ADC, serial

Of 512 KB. The Arduino build

Of 96 KB. 2 KB of it is the

About four passes per second.

Two buttons and serial

used about 42 KB.

screen buffer and its sent

receive; all else polled.

copy. No heap.

Where one pass goes (estimated)

Zone pings and gaps, ≈125 ms

OLED, up to ≈95 ms
only pages that changed

2 × 60 ms gap + echo time

RESULTS

# Challenges and how they were resolved

Problem | Cause | Resolution
OLED stayed blank on the Blackpill | No debugger to inspect the board | Moved to the Nucleo with its on-board ST-LINK
OpenOCD could not connect | ST-LINK firmware from 2019 | Flashed with STM32_Programmer_CLI over SWD
One zone LED would not light | Breadboard wiring; the fault moved when pins were swapped | Rewired the LED path
Third ultrasonic sensor unreliable | Persistent wiring fault | Design finalised with two zones
OLED froze on an old frame after the pot was added | Not confirmed | Pot removed and USB power cycled; display recovered
Fan speed potentiometer failed | Faulty part | Four fan levels stepped by the blue button
No free pin near D6 for a second menu button | Crowded header | One button on D11: tap = next screen, hold 2 s = select

Most faults were wiring, not firmware. Checking each wire against the pin map, with the Arduino build as a known-good reference, was the

# Extensions and improvements

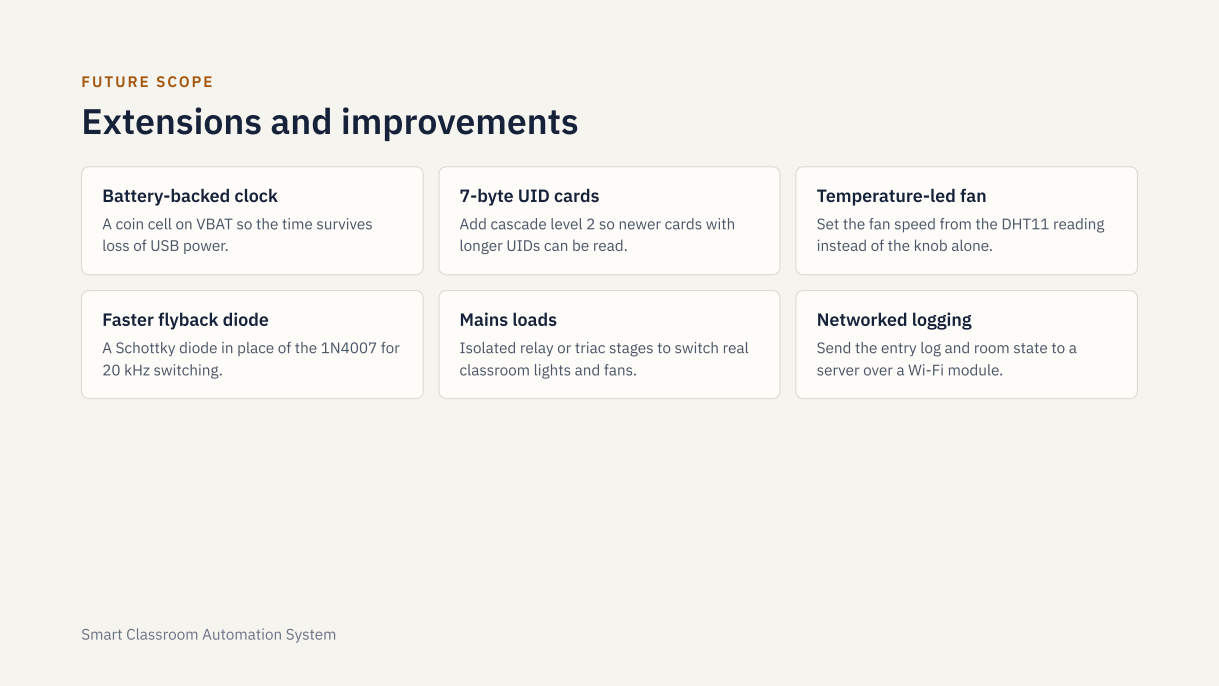
[picture p54: page 35]
FUTURE SCOPE; 20 kHz switching.; Mains loads; Networked logging

Battery-backed clock

7-byte UID cards

Temperature-led fan

A coin cell on VBAT so the time survives

Add cascade level 2 so newer cards with

Set the fan speed from the DHT11 reading

loss of USB power.

longer UIDs can be read.

instead of the knob alone.

Faster flyback diode

A Schottky diode in place of the 1N4007 for

Isolated relay or triac stages to switch real

Send the entry log and room state to a

classroom lights and fans.

server over a Wi-Fi module.

DEMONSTRATION

# Live demonstration sequence

# | Action | What to watch | Who

1 | Power the board, type ? on serial | HOME screen; date, time and clock source | Member C
2 | Cover the LDR, stand in zone A for 5 s | Zone A shows OCC, light turns on | Member D
3 | Press the blue button once, tap a card | FAN:33, IN count 1; fan kicks, then runs | Member A, B
4 | Tap the teacher card | CLASS START on serial; CLASS 0M on HOME | Member B
5 | Tap D11 through ROSTER, LOG, CLASS | Names, times, T for teacher; events in order | Member D
6 | On CLASS: turn knob to 0, hold D11 2 s | SAVED: 0 MIN; the next student is LATE | Member D
7 | Tap a second card, open GRAPH | L next to the name; humidity or people curve | Member B, D
8 | Tap the teacher card again | CLASS END; summary printed on serial | Member B
9 | Tap the other cards out, leave zone A | Fan stops; light off after 10 s | Member B, D

SU M M ARY

# Two occupancy-sensed zones, RFID attendance with teacher sessions, a

PWM fan gated by the headcount, a one-button five-screen interface,

# temperature, humidity and a real-time clock, all on register-level

firmware.

# Thank you

Questions are welcome.
