modi0903/smart-classroom-stm32/docs/images/screens/graph-hum.png

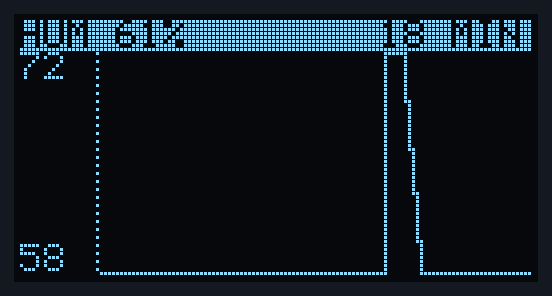
docs/images/screens/graph-hum.png
