modi0903/smart-classroom-stm32/docs/images/screens/log-hold.png

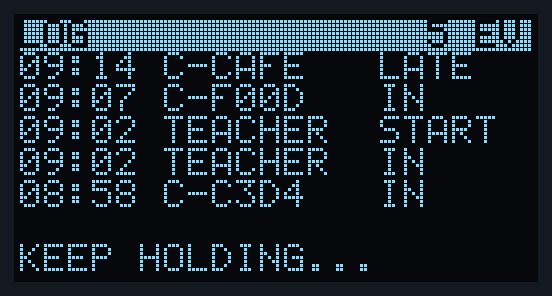
docs/images/screens/log-hold.png
