modi0903/smart-classroom-stm32/(commit log)

2026-10-15 RFID at the door: RC522 over SPI2, card roster with lockout
    Bare-metal CMSIS firmware on the Nucleo-F401RE: two HC-SR04 zones with
    asymmetric debounce, PWM zone lights, LDR, DHT11, SH1106 OLED over I2C,
    and the RC522 reader with an IN/OUT roster.
2026-10-18 Light dimmer pot, on-chip RTC, button and UART interrupts
    ADC1 light pot with dead band, RTC on the LSE crystal with backup-register
    fingerprint, serial T/D/? commands through a USART2 RX ring buffer, and the
    blue button on EXTI13 as an override.
2026-10-19 Fan: IRLZ44N low-side driver on TIM1 at 20 kHz, gated by the RFID headcount
    Fan speed pot on A2, 60 % voltage cap for the 9 V battery, 0.3 s kick-start.
    This is the build described in the lab report.
2026-10-28 v2: five-screen OLED interface, teacher sessions, event log, graphs
    - lights follow the zone sensors only (a tap no longer lights both zones)
    - card names, teacher card starts and ends a class, LATE marking
    - 32-event log, temperature/humidity/people graphs, frame buffer that sends
    only changed pages
    - self-contained CMake build (-Os, ST startup and system files)
    Claude-Session: https://claude.ai/code/session_018SsX6AhgfoPqnXMZvyGdBc
    [extras.h, host_test.c, logic.h, main.c]
2026-10-28 v2.1: one menu button, blue button steps the fan level
    - D11 only: tap = next screen, hold 2 s = select (D6 was not reachable)
    - blue button: fan level 0/33/66/100, driven as 0/35/68/100 %
    (the fan potentiometer failed); no light/fan override
    - this is the build running on the board
    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
    [extras.h, host_test.c, main.c]
2026-10-29 Docs, PC simulator, CI, report and slides
    - README with setup photo, screens, pin summary, build steps, team
    - docs/: hardware, firmware internals (I2C, SPI/RC522, UART, PWM, RTC,
    DHT11, interrupts), user guide, testing, project history
    - tools/oled-sim: compiles main.c on a PC against RAM-backed registers,
    renders every screen and tests the menu button's tap/hold logic
    - GitHub Actions: firmware build, 551 host checks, simulator
    - docs/reports: lab report (v1 build) and final review slides
    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
